EnzoPerrier/CE005_CPU-soldering-fan/005_CPU soldering fan.kicad_sch

## KiCad design 005_CPU soldering fan.kicad_sch (2026-10-06)

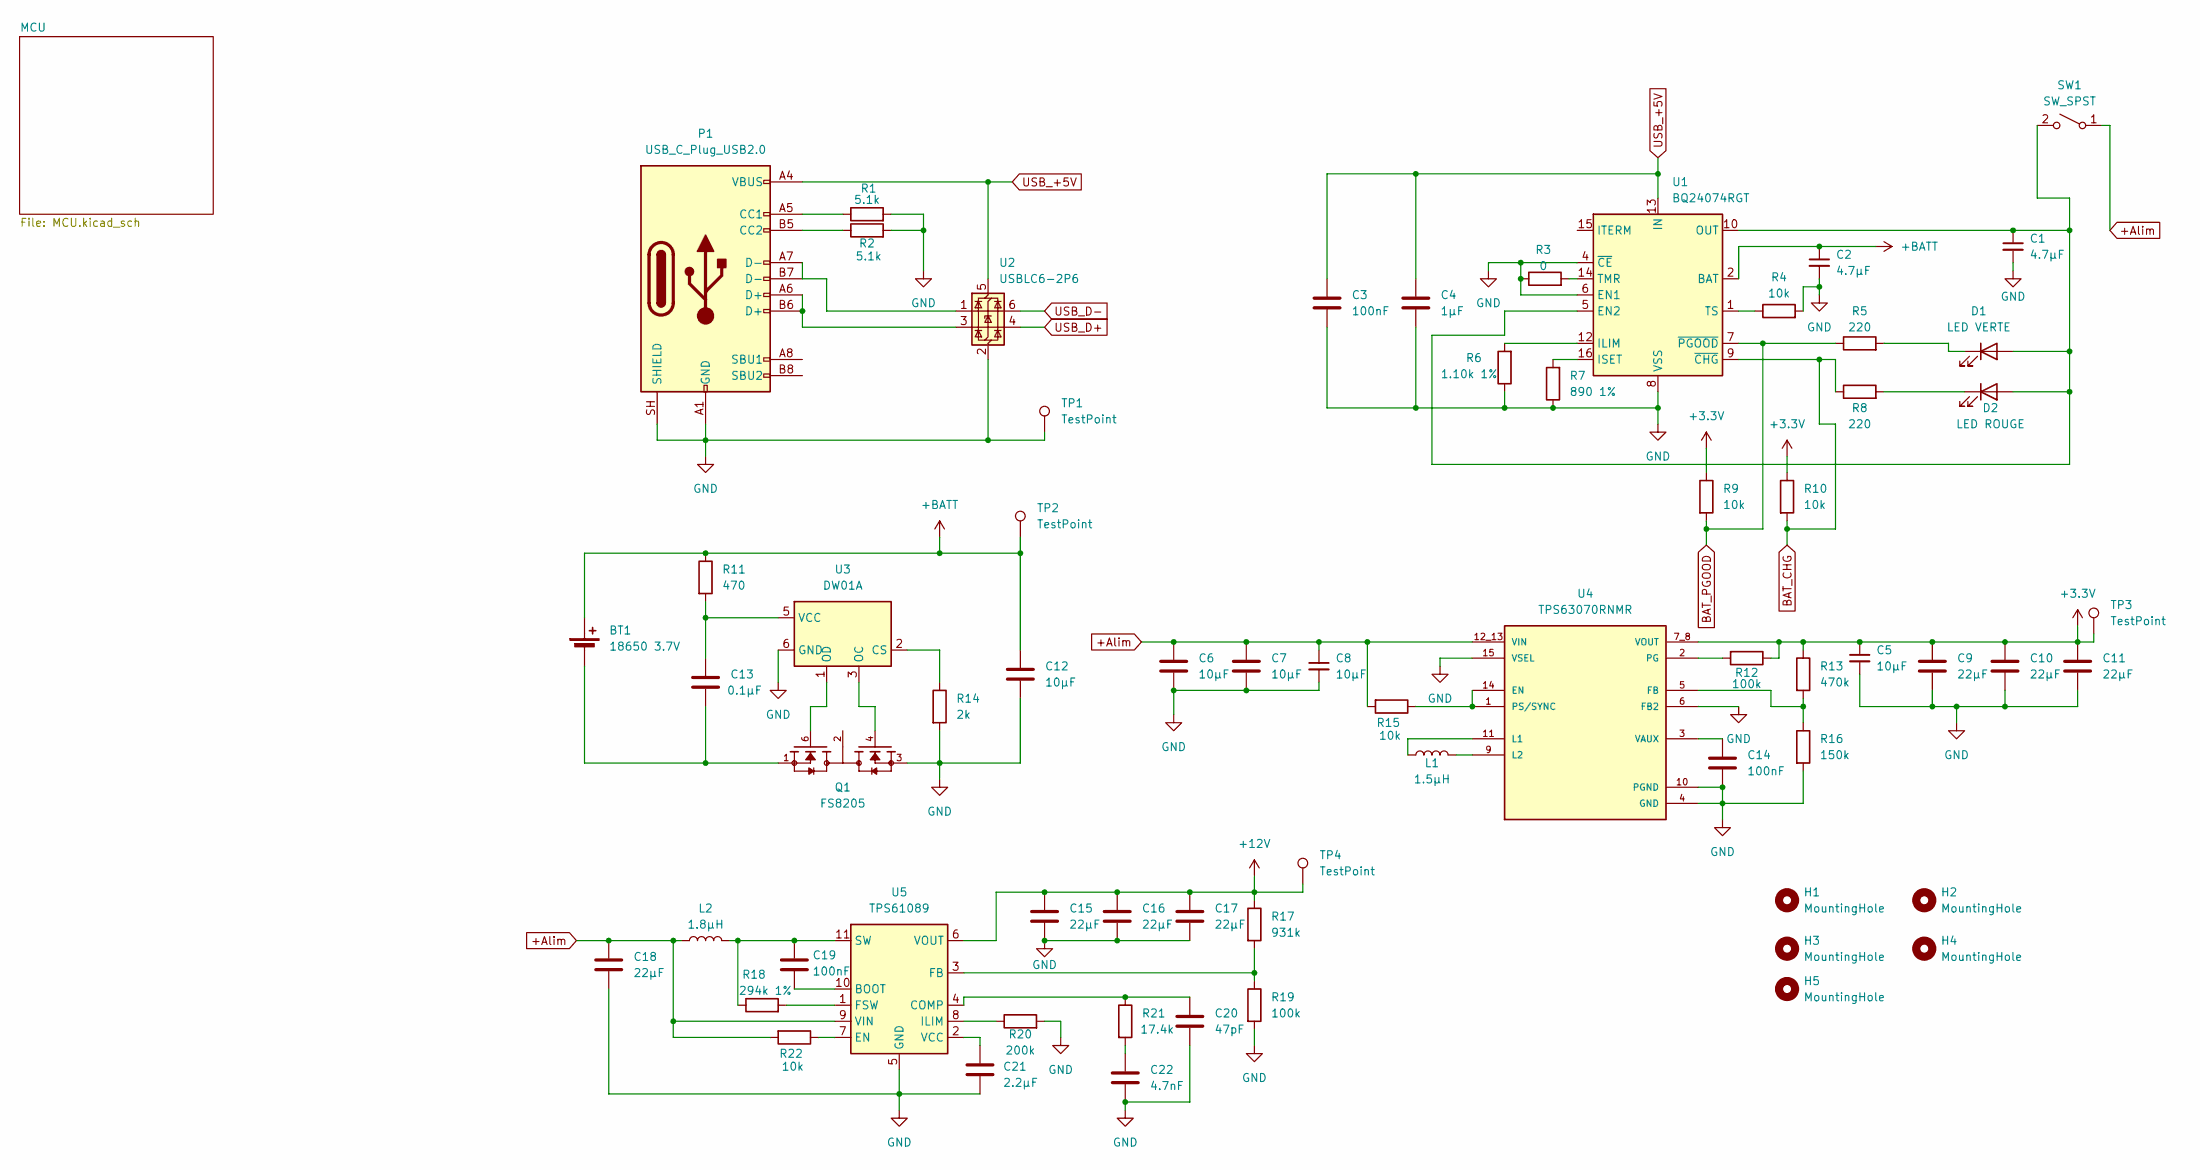
[picture p1: schematic 005_CPU soldering fan.kicad_sch]

Parts:
BT1: 18650 3.7V; SolderWire-0.75sqmm_1x02_P4.8mm_D1.25mm_OD2.3mm
C1, C2: 4.7µF; C_0805_2012Metric
C3, C19: 100nF; C_0805_2012Metric
C4: 1µF; C_1206_3216Metric
C5, C8: 10µF; C_0603_1608Metric
C6, C7: 10µF; C_0805_2012Metric
C9, C10, C11, C15, C16, C17, C18: 22µF; C_1210_3225Metric
C12: 10µF; C_1210_3225Metric
C13: 0.1µF; C_0805_2012Metric
C14: 100nF; C_0603_1608Metric
C20: 47pF; C_0805_2012Metric
C21: 2.2µF; C_0805_2012Metric
C22: 4.7nF; C_0805_2012Metric
D1: LED VERTE; LED_1206_3216Metric
D2: LED ROUGE; LED_1206_3216Metric
H1, H2, H3, H4, H5: MountingHole; MountingHole_3.2mm_M3_DIN965_Pad_TopBottom
L1: 1.5µH; IND_XFL4020-152MEC
L2: 1.8µH; IND_CDMC8D28NP1R8MC
P1: USB_C_Plug_USB2.0; USB_C_Receptacle_GCT_USB4105-xx-A_16P_TopMnt_Horizontal
Q1: FS8205; SOT95P280X145-6N; PARTREV 1.9
R1, R2: 5.1k; R_0805_2012Metric
R3: 0; R_0805_2012Metric
R4, R9, R10, R15, R22: 10k; R_0805_2012Metric
R5, R8: 220; R_0805_2012Metric
R6: 1.10k 1%; R_0805_2012Metric
R7: 890 1%; R_0805_2012Metric
R11: 470; R_0805_2012Metric
R12, R19: 100k; R_0805_2012Metric
R13: 470k; R_0805_2012Metric
R14: 2k; R_0805_2012Metric
R16: 150k; R_0805_2012Metric
R17: 931k; R_0805_2012Metric
R18: 294k 1%; R_0805_2012Metric
R20: 200k; R_0805_2012Metric
R21: 17.4k; R_0805_2012Metric
SW1: SW_SPST; JST_EH_B2B-EH-A_1x02_P2.50mm_Vertical
TP1: TestPoint; TestPoint_Pad_1.0x1.0mm
TP2, TP3, TP4: TestPoint; TestPoint_Pad_D1.0mm
U1: BQ24074RGT; VQFN-16-1EP_3x3mm_P0.5mm_EP1.6x1.6mm
U2: USBLC6-2P6; SOT-666
U3: DW01A; SOT-23-6
U4: TPS63070RNMR; VREG_TPS63070RNMR; PARTREV B
U5: TPS61089; Texas_VQFN-RNR0011A-11

Connections:
+3.3V: C5.1, C9.1, C10.1, C11.1, R9.1, R10.1, R12.1, R13.1, TP3.1, U4.7_8 (VOUT)
+12V: C15.1, C16.1, C17.1, R17.1, TP4.1, U5.6 (VOUT)
+Alim: C6.1, C7.1, C8.1, C18.1, L2.1, R15.2, R22.2, SW1.1 (A), U4.12_13 (VIN), U5.9 (VIN)
+BATT: BT1.1 (+), C2.1, C12.1, R11.1, TP2.1, U1.2 (BAT), U1.3 (BAT)
BAT_CHG: R8.1, R10.2, U1.9 (~CHG)
BAT_PGOOD: R5.1, R9.2, U1.7 (~PGOOD)
GND: C1.2, C2.2, C3.2, C4.2, C5.2, C6.2, C7.2, C8.2, C9.2, C10.2, C11.2, C12.2, C14.2, C15.2, C16.2, C17.2, C18.2, C20.2, C21.2, C22.2, P1.A1 (GND), P1.A12 (GND), P1.B1 (GND), P1.B12 (GND), P1.SH (SHIELD), Q1.3, R1.2, R2.2, R3.1, R4.2, R6.1, R7.1, R14.2, R16.2, R19.2, R20.2, TP1.1, U1.4 (~CE), U1.6 (EN1), U1.8 (VSS), U1.17 (VSS), U2.2 (GND), U3.6 (GND), U4.4 (GND), U4.6 (FB2), U4.10 (PGND), U4.15 (VSEL), U5.5 (GND)
unnamed: BT1.2 (-), C13.2, Q1.1
unnamed: C1.1, D1.2 (A), D2.2 (A), SW1.2 (B), U1.5 (EN2), U1.10 (OUT), U1.11 (OUT)
unnamed: C13.1, R11.2, U3.5 (VCC)
unnamed: C14.1, U4.3 (VAUX)
unnamed: C19.1, L2.2, R18.1, U5.11 (SW)
unnamed: C19.2, U5.10 (BOOT)
unnamed: C20.1, R21.1, U5.4 (COMP)
unnamed: C21.1, U5.2 (VCC)
unnamed: C22.1, R21.2
unnamed: D1.1 (K), R5.2
unnamed: D2.1 (K), R8.2
unnamed: L1.1, U4.11 (L1)
unnamed: L1.2, U4.9 (L2)
unnamed: P1.A5 (CC1), R1.1
unnamed: P1.A6 (D+), P1.B6 (D+), U2.3 (I/O2)
unnamed: P1.A7 (D-), P1.B7 (D-), U2.1 (I/O1)
unnamed: P1.B5 (CC2), R2.1
unnamed: Q1.2, Q1.5
unnamed: Q1.4, U3.3 (OC)
unnamed: Q1.6, U3.1 (OD)
unnamed: R3.2, U1.14 (TMR)
unnamed: R4.1, U1.1 (TS)
unnamed: R6.2, U1.12 (ILIM)
unnamed: R7.2, U1.16 (ISET)
unnamed: R12.2, U4.2 (PG)
unnamed: R13.2, R16.1, U4.5 (FB)
unnamed: R14.1, U3.2 (CS)
unnamed: R15.1, U4.1 (PS/SYNC), U4.14 (EN)
unnamed: R17.2, R19.1, U5.3 (FB)
unnamed: R18.2, U5.1 (FSW)
unnamed: R20.1, U5.8 (ILIM)
unnamed: R22.1, U5.7 (EN)
USB_+5V: C3.1, C4.1, P1.A4 (VBUS), P1.A9 (VBUS), P1.B4 (VBUS), P1.B9 (VBUS), U1.13 (IN), U2.5 (VBUS)
USB_D+: U2.4 (I/O2)
USB_D-: U2.6 (I/O1)
