EnzoPerrier/CE005_CPU-soldering-fan/MCU.kicad_sch

## KiCad design MCU.kicad_sch (2026-10-06)

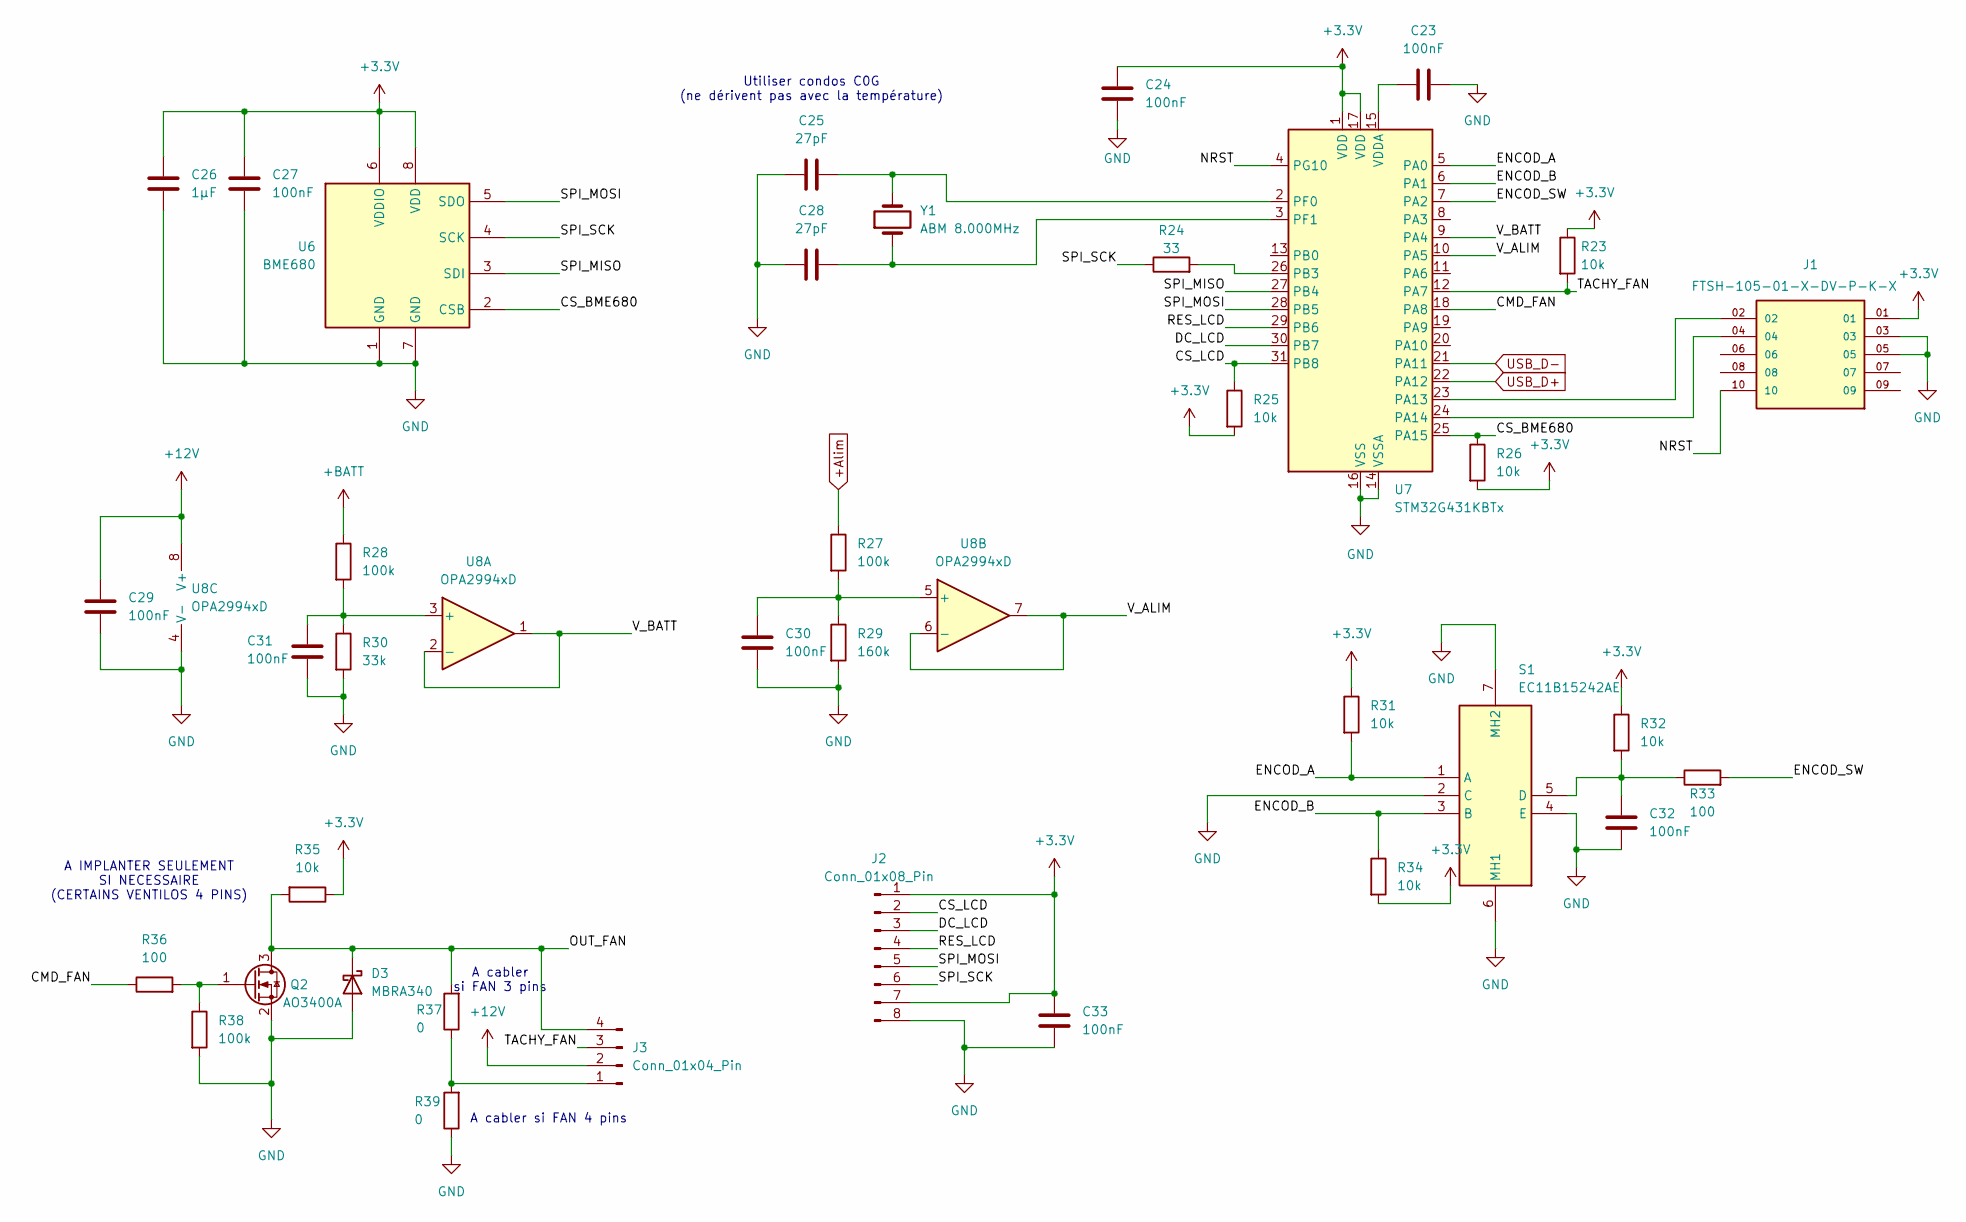
[picture p2: schematic MCU.kicad_sch]

Parts:
C23, C24, C27, C29, C30, C31, C32, C33: 100nF; C_0805_2012Metric
C25, C28: 27pF; C_0805_2012Metric
C26: 1µF; C_0805_2012Metric
D3: MBRA340; D_SMA
J1: FTSH-105-01-X-DV-P-K-X; SAMTEC_FTSH-105-01-X-DV-P-K-X; PARTREV H
J2: Conn_01x08_Pin; JST_EH_B8B-EH-A_1x08_P2.50mm_Vertical
J3: Conn_01x04_Pin; PinHeader_1x04_P2.54mm_Vertical
Q2: AO3400A; SOT-23
R23, R25, R26, R31, R32, R34, R35: 10k; R_0805_2012Metric
R24: 33; R_0805_2012Metric
R27, R28, R38: 100k; R_0805_2012Metric
R29: 160k; R_0805_2012Metric
R30: 33k; R_0805_2012Metric
R33, R36: 100; R_0805_2012Metric
R37, R39: 0; R_1210_3225Metric
S1: EC11B15242AE; Manufacturer_Part_Number EC11B15242AE; Mouser Part Number 688-EC11B15242AE
U6: BME680; Bosch_LGA-8_3x3mm_P0.8mm_ClockwisePinNumbering
U7: STM32G431KBTx; LQFP-32_7x7mm_P0.8mm
U8: OPA2994xD; SOIC-8_3.9x4.9mm_P1.27mm
Y1: ABM 8.000MHz; Crystal_SMD_Abracon_ABM3-2Pin_5.0x3.2mm_HandSoldering

Connections:
+3.3V: C24.1, C26.1, C27.1, C33.1, J1.01, J2.1, J2.7, R23.1, R25.2, R26.2, R31.1, R32.1, R34.2, R35.1, U6.6 (VDDIO), U6.8 (VDD), U7.1 (VDD), U7.17 (VDD)
+12V: C29.1, J3.2, U8.8 (V+)
+Alim: R27.1
+BATT: R28.1
CMD_FAN: R36.1, U7.18 (PA8)
CS_BME680: R26.1, U6.2 (CSB), U7.25 (PA15)
CS_LCD: J2.2, R25.1, U7.31 (PB8)
DC_LCD: J2.3, U7.30 (PB7)
ENCOD_A: R31.2, S1.1 (A), U7.5 (PA0)
ENCOD_B: R34.1, S1.3 (B), U7.6 (PA1)
ENCOD_SW: R33.2, U7.7 (PA2)
GND: C23.2, C24.2, C25.1, C26.2, C27.2, C28.1, C29.2, C30.2, C31.2, C32.2, C33.2, D3.2 (A), J1.03, J1.05, J2.8, Q2.2 (S), R29.2, R30.2, R38.2, R39.1, S1.2 (C), S1.4 (E), S1.6 (MH1), S1.7 (MH2), U6.1 (GND), U6.7 (GND), U7.14 (VSSA), U7.16 (VSS), U7.32 (VSS), U8.4 (V-)
NRST: J1.10, U7.4 (PG10)
unnamed: C23.1, U7.15 (VDDA)
unnamed: C25.2, U7.2 (PF0), Y1.2
unnamed: C28.2, U7.3 (PF1), Y1.1
unnamed: C30.1, R27.2, R29.1, U8.5 (+)
unnamed: C31.1, R28.2, R30.1, U8.3 (+)
unnamed: C32.1, R32.2, R33.1, S1.5 (D)
unnamed: J1.02, U7.23 (PA13)
unnamed: J1.04, U7.24 (PA14)
unnamed: J3.1, R37.1, R39.2
unnamed: Q2.1 (G), R36.2, R38.1
unnamed: R24.2, U7.26 (PB3)
OUT_FAN: D3.1 (K), J3.4, Q2.3 (D), R35.2, R37.2
RES_LCD: J2.4, U7.29 (PB6)
SPI_MISO: U6.3 (SDI), U7.27 (PB4)
SPI_MOSI: J2.5, U6.5 (SDO), U7.28 (PB5)
SPI_SCK: J2.6, R24.1, U6.4 (SCK)
TACHY_FAN: J3.3, R23.2, U7.12 (PA7)
USB_D+: U7.22 (PA12)
USB_D-: U7.21 (PA11)
V_ALIM: U7.10 (PA5), U8.6 (-), U8.7
V_BATT: U7.9 (PA4), U8.1, U8.2 (-)

Notes on the sheet:
Utiliser condos C0G (ne dérivent pas avec la température)
A cabler si FAN 4 pins
A cabler si FAN 3 pins
A IMPLANTER SEULEMENT SI NECESSAIRE (CERTAINS VENTILOS 4 PINS)
