EnzoPerrier/CE005_CPU-soldering-fan/005_CPU soldering fan.ioc

Mcu.UserName=STM32G431KBTx
PA0.GPIO_Label=ENCOD_A
PA0.Signal=S_TIM2_CH1
PA1.GPIO_Label=ENCOD_B
PA1.Signal=S_TIM2_CH2
PA11.Signal=USB_DM
PA12.Signal=USB_DP
PA13.Signal=SYS_JTMS-SWDIO
PA14.Signal=SYS_JTCK-SWCLK
PA15.GPIO_Label=CS_BME680
PA15.Signal=GPIO_Output
PA2.GPIO_Label=ENCOD_SW
PA2.Signal=GPIO_Input
PA4.GPIO_Label=V_BATT
PA4.Signal=ADC2_IN17
PA5.GPIO_Label=V_ALIM
PA5.Signal=ADC2_IN13
PA7.GPIO_Label=TACHY_FAN
PA7.Signal=S_TIM3_CH2
PA8.GPIO_Label=CMD_FAN
PA8.Signal=S_TIM1_CH1
PB3.GPIO_Label=SPI_SCK
PB3.Signal=SPI1_SCK
PB4.GPIO_Label=SPI_MISO
PB4.Signal=SPI1_MISO
PB5.GPIO_Label=SPI_MOSI
PB5.Signal=SPI1_MOSI
PB6.GPIO_Label=RES_LCD
PB6.Signal=GPIO_Output
PB7.GPIO_Label=DC_LCD
PB7.Signal=GPIO_Output
PB8-BOOT0.GPIO_Label=CS_LCD
PB8-BOOT0.Signal=GPIO_Output
PF0-OSC_IN.Signal=RCC_OSC_IN
PF1-OSC_OUT.Signal=RCC_OSC_OUT
