EnzoPerrier/CE005_CPU-soldering-fan/(commit log)

2026-09-10 [SCH & PCB] Modif diode unique KKA --> Passage en 2 diodes + Modif cablage ecran
    [005_CPU soldering fan-B_Cu.gbl, 005_CPU soldering fan-B_Mask.gbs, 005_CPU soldering fan-B_Paste.gbp, 005_CPU soldering fan-B_Silkscreen.gbo, 005_CPU soldering fan-Edge_Cuts.gm1, 005_CPU soldering fan-F_Cu.gtl, 005_CPU soldering fan-F_Mask.gts, 005_CPU soldering fan-F_Paste.gtp]
2026-10-06 MAJ fichiers fab, BOM à éditer
    [005_CPU soldering fan-B_Cu.gbl, 005_CPU soldering fan-B_Mask.gbs, 005_CPU soldering fan-B_Paste.gbp, 005_CPU soldering fan-B_Silkscreen.gbo, 005_CPU soldering fan-Edge_Cuts.gm1, 005_CPU soldering fan-F_Cu.gtl, 005_CPU soldering fan-F_Mask.gts, 005_CPU soldering fan-F_Paste.gtp]
2026-10-07 MAJ PCB + Fichiers de FAB OK
    [005_CPU soldering fan-B_Cu.gbl, 005_CPU soldering fan-B_Mask.gbs, 005_CPU soldering fan-B_Paste.gbp, 005_CPU soldering fan-B_Silkscreen.gbo, 005_CPU soldering fan-Edge_Cuts.gm1, 005_CPU soldering fan-F_Cu.gtl, 005_CPU soldering fan-F_Mask.gts, 005_CPU soldering fan-F_Paste.gtp]
2026-10-08 Fichiers de fab avec plugin JLCPCB
    [005_CPU soldering fan-B_Cu.gbl, 005_CPU soldering fan-B_Mask.gbs, 005_CPU soldering fan-B_Paste.gbp, 005_CPU soldering fan-B_Silkscreen.gbo, 005_CPU soldering fan-Edge_Cuts.gm1, 005_CPU soldering fan-F_Cu.gtl, 005_CPU soldering fan-F_Mask.gts, 005_CPU soldering fan-F_Paste.gtp]
